s-park21/RFM95_Transparent_Serial/RFM95_Serial_Converter_PCB/Local_Library/3D_Models/Amphenol 132415.STEP

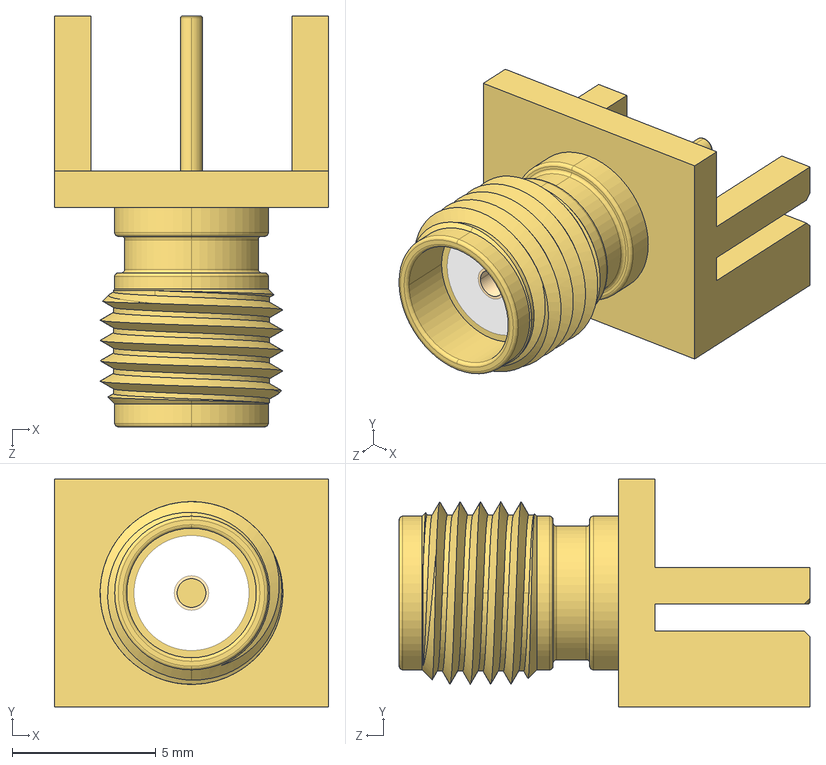
[picture p1: CAD file, 2022-06-12]
RFM95_Serial_Converter_PCB/Local_Library/3D_Models/Amphenol 132415.STEP
9.52 x 7.92 x 14.3 mm
