s-park21/RFM95_Transparent_Serial/RFM95_Serial_Converter_PCB/Local_Library/3D_Models/SM06B-GHS-TB_LF__SN_.step

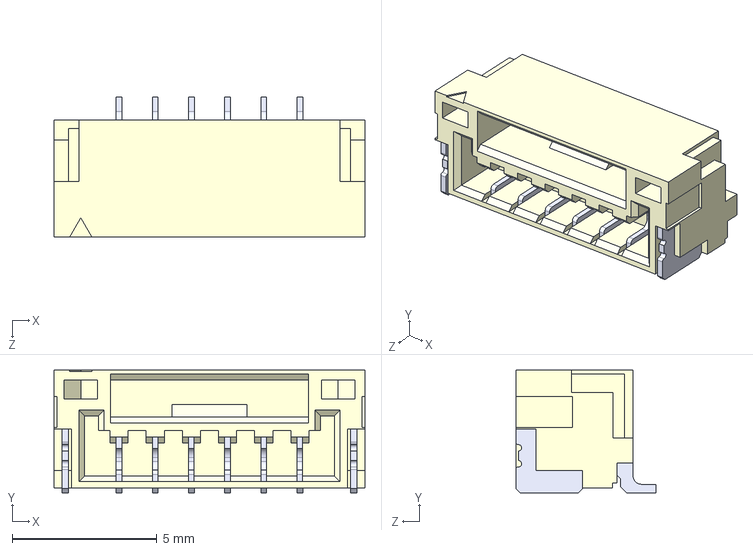
[picture p2: CAD file, 2022-06-11]
RFM95_Serial_Converter_PCB/Local_Library/3D_Models/SM06B-GHS-TB_LF__SN_.step
10.8 x 4.25 x 4.85 mm
