s-park21/RFM95_Transparent_Serial/RFM95_Serial_Converter_PCB/RFM95_Serial_Converter_PCB.kicad_pcb

## KiCad design RFM95_Serial_Converter_PCB/RFM95_Serial_Converter_PCB.kicad_pcb (2022-07-09)

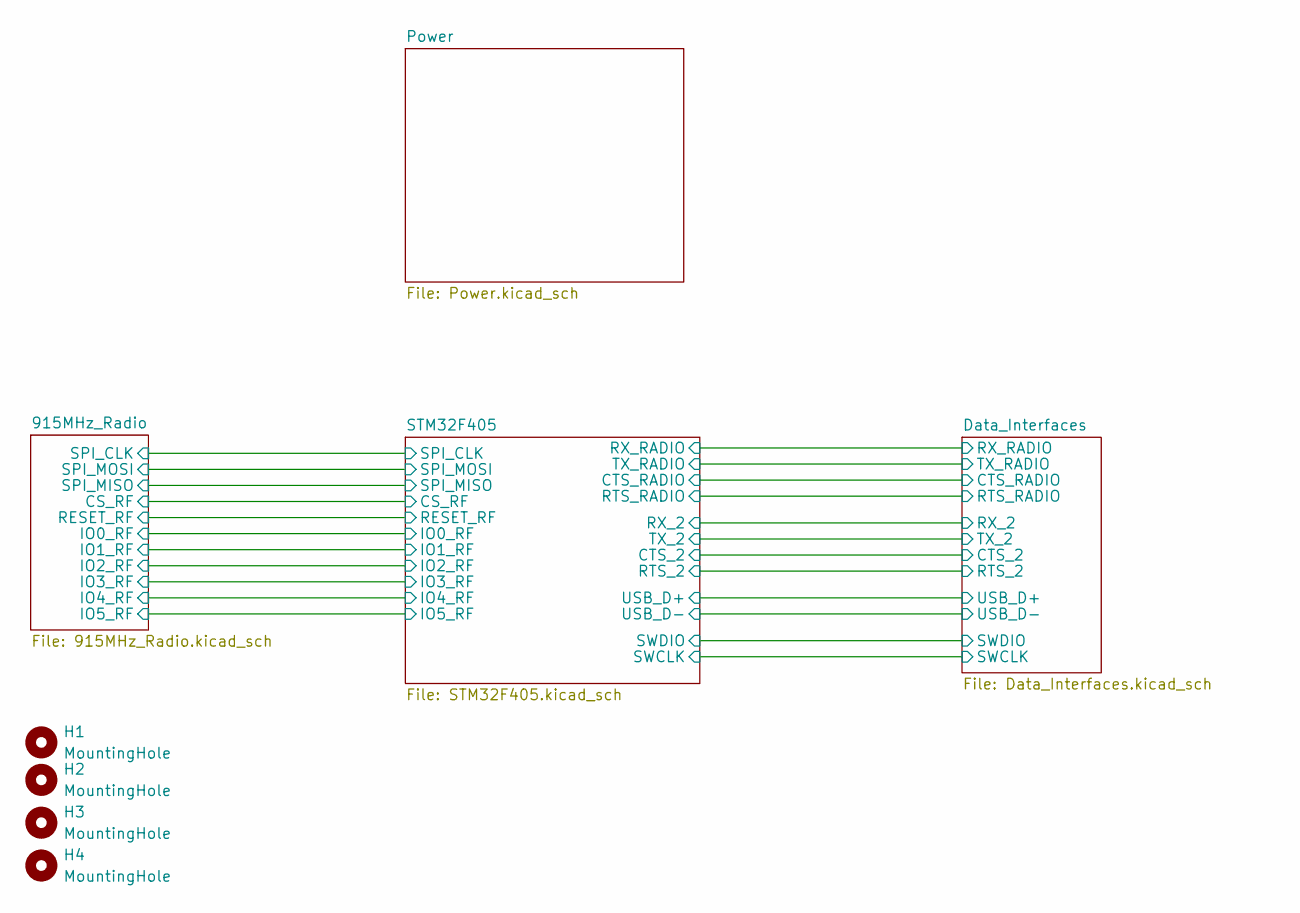
[picture p3: schematic RFM95_Serial_Converter_PCB.kicad_sch]

Parts:
H1, H2, H3, H4: MountingHole; MountingHole_2.5mm_Pad

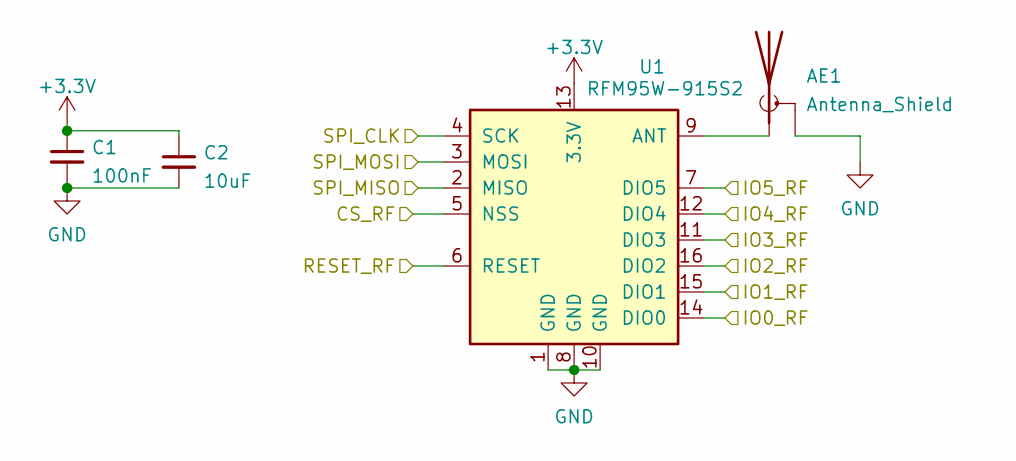
[picture p4: schematic 915MHz_Radio.kicad_sch]

Parts:
AE1: Antenna_Shield; SMA_Amphenol_132289_EdgeMount; LCSC C496550
C1: 100nF; C_0603_1608Metric_Pad1.08x0.95mm_HandSolder
C2: 10uF; C_0603_1608Metric_Pad1.08x0.95mm_HandSolder
U1: RFM95W-915S2; HOPERF_RFM9XW_SMD

Connections:
+3V3: C1.1, C2.1, U1.13 (3.3V); also elsewhere on the board
/915MHz_Radio/CS_RF: U1.5 (NSS); also elsewhere on the board
/915MHz_Radio/IO0_RF: U1.14 (DIO0); also elsewhere on the board
/915MHz_Radio/IO1_RF: U1.15 (DIO1); also elsewhere on the board
/915MHz_Radio/IO2_RF: U1.16 (DIO2); also elsewhere on the board
/915MHz_Radio/IO3_RF: U1.11 (DIO3); also elsewhere on the board
/915MHz_Radio/IO4_RF: U1.12 (DIO4); also elsewhere on the board
/915MHz_Radio/IO5_RF: U1.7 (DIO5); also elsewhere on the board
/915MHz_Radio/RESET_RF: U1.6 (RESET); also elsewhere on the board
/915MHz_Radio/SPI_CLK: U1.4 (SCK); also elsewhere on the board
/915MHz_Radio/SPI_MISO: U1.2 (MISO); also elsewhere on the board
/915MHz_Radio/SPI_MOSI: U1.3 (MOSI); also elsewhere on the board
GND: AE1.2 (Shield), C1.2, C2.2, U1.1 (GND), U1.8 (GND), U1.10 (GND); also elsewhere on the board
unnamed: AE1.1 (A), U1.9 (ANT)

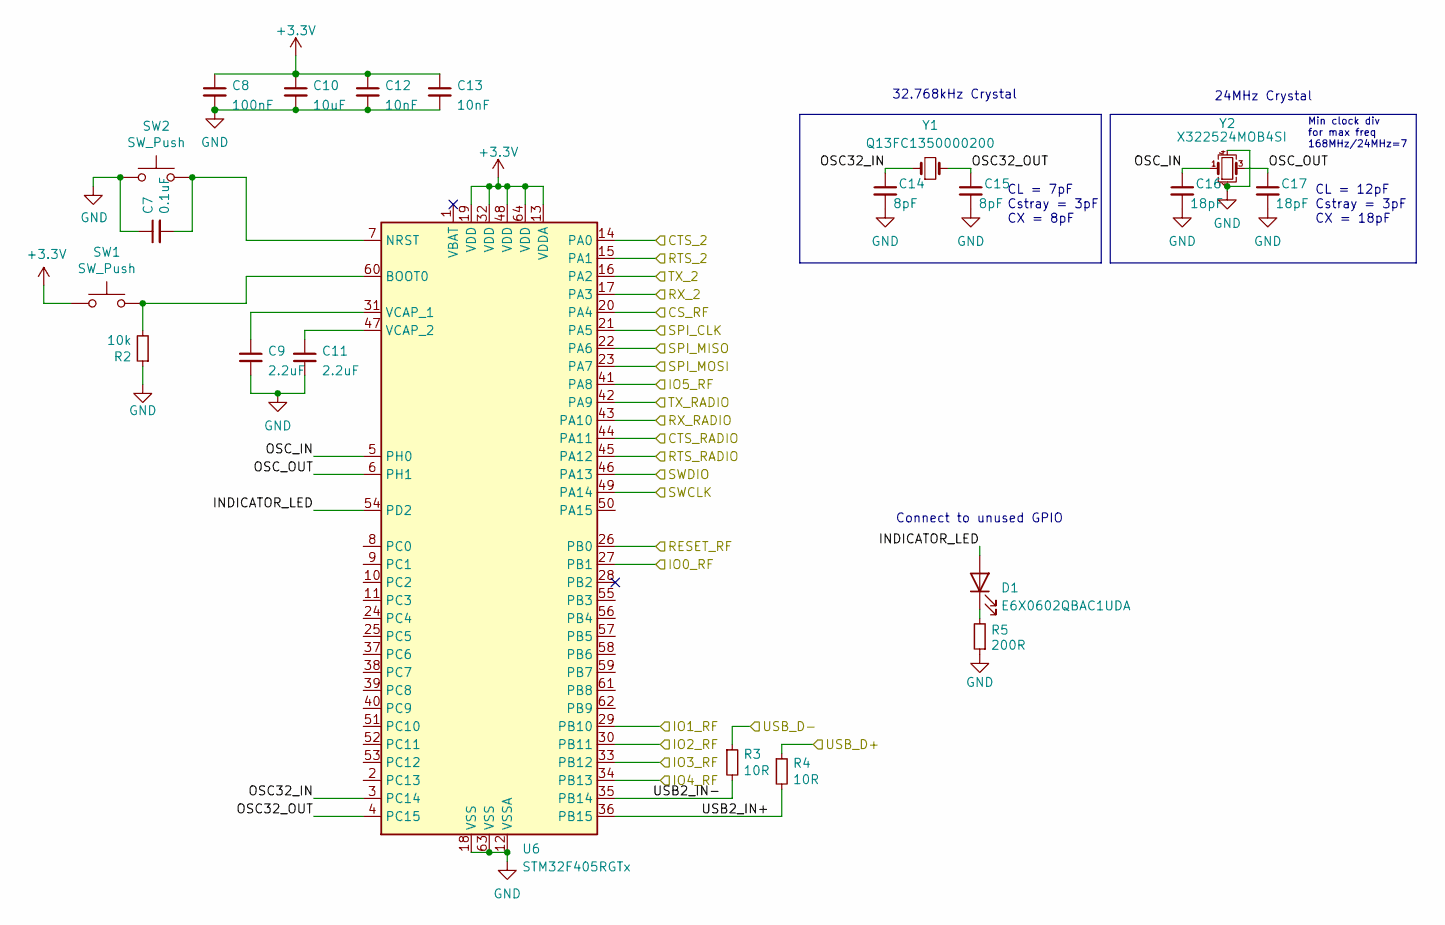
[picture p5: schematic STM32F405.kicad_sch]

Parts:
C7: 0.1uF; C_0603_1608Metric_Pad1.08x0.95mm_HandSolder
C8: 100nF; C_0603_1608Metric_Pad1.08x0.95mm_HandSolder
C9, C11: 2.2uF; C_0603_1608Metric_Pad1.08x0.95mm_HandSolder
C10: 10uF; C_0603_1608Metric_Pad1.08x0.95mm_HandSolder
C12, C13: 10nF; C_0603_1608Metric_Pad1.08x0.95mm_HandSolder
C14, C15: 8pF; C_0603_1608Metric_Pad1.08x0.95mm_HandSolder
C16, C17: 18pF; C_0603_1608Metric_Pad1.08x0.95mm_HandSolder
D1: E6X0602QBAC1UDA; LED_0603_1608Metric_Pad1.05x0.95mm_HandSolder; MFR# E6X0602QBAC1UDA; LCSC# C375467
R2: 10k; R_0603_1608Metric_Pad0.98x0.95mm_HandSolder
R3, R4: 10R; R_0603_1608Metric_Pad0.98x0.95mm_HandSolder
R5: 200R; R_0603_1608Metric_Pad0.98x0.95mm_HandSolder
SW1, SW2: SW_Push; SW_Push_1P1T_NO_CK_KSC6xxJ
U6: STM32F405RGTx; LQFP-64_10x10mm_P0.5mm
Y1: Q13FC1350000200; Crystal_SMD_3215-2Pin_3.2x1.5mm; LCSC C48615
Y2: X322524MOB4SI; Crystal_SMD_3225-4Pin_3.2x2.5mm; LCSC C70590

Connections:
+3V3: C8.1, C10.1, C12.1, C13.1, SW1.1, U6.13 (VDDA), U6.19 (VDD), U6.32 (VDD), U6.48 (VDD), U6.64 (VDD); also elsewhere on the board
/915MHz_Radio/CS_RF: U6.20 (PA4); also elsewhere on the board
/915MHz_Radio/IO0_RF: U6.27 (PB1); also elsewhere on the board
/915MHz_Radio/IO1_RF: U6.29 (PB10); also elsewhere on the board
/915MHz_Radio/IO2_RF: U6.30 (PB11); also elsewhere on the board
/915MHz_Radio/IO3_RF: U6.33 (PB12); also elsewhere on the board
/915MHz_Radio/IO4_RF: U6.34 (PB13); also elsewhere on the board
/915MHz_Radio/IO5_RF: U6.41 (PA8); also elsewhere on the board
/915MHz_Radio/RESET_RF: U6.26 (PB0); also elsewhere on the board
/915MHz_Radio/SPI_CLK: U6.21 (PA5); also elsewhere on the board
/915MHz_Radio/SPI_MISO: U6.22 (PA6); also elsewhere on the board
/915MHz_Radio/SPI_MOSI: U6.23 (PA7); also elsewhere on the board
/Data_Interfaces/CTS_2: U6.14 (PA0); also elsewhere on the board
/Data_Interfaces/CTS_RADIO: U6.44 (PA11); also elsewhere on the board
/Data_Interfaces/RTS_2: U6.15 (PA1); also elsewhere on the board
/Data_Interfaces/RTS_RADIO: U6.45 (PA12); also elsewhere on the board
/Data_Interfaces/RX_2: U6.17 (PA3); also elsewhere on the board
/Data_Interfaces/RX_RADIO: U6.43 (PA10); also elsewhere on the board
/Data_Interfaces/SWCLK: U6.49 (PA14); also elsewhere on the board
/Data_Interfaces/SWDIO: U6.46 (PA13); also elsewhere on the board
/Data_Interfaces/TX_2: U6.16 (PA2); also elsewhere on the board
/Data_Interfaces/TX_RADIO: U6.42 (PA9); also elsewhere on the board
/Data_Interfaces/USB_D+: R4.1; also elsewhere on the board
/Data_Interfaces/USB_D-: R3.1; also elsewhere on the board
/STM32F405/INDICATOR_LED: D1.2 (A), U6.54 (PD2)
/STM32F405/OSC32_IN: C14.1, U6.3 (PC14), Y1.1
/STM32F405/OSC32_OUT: C15.1, U6.4 (PC15), Y1.2
/STM32F405/OSC_IN: C16.1, U6.5 (PH0), Y2.1
/STM32F405/OSC_OUT: C17.1, U6.6 (PH1), Y2.3
/STM32F405/USB2_IN+: R4.2, U6.36 (PB15)
/STM32F405/USB2_IN-: R3.2, U6.35 (PB14)
GND: C7.1, C8.2, C9.2, C10.2, C11.2, C12.2, C13.2, C14.2, C15.2, C16.2, C17.2, R2.1, R5.1, SW2.1, U6.12 (VSSA), U6.18 (VSS), U6.63 (VSS), Y2.2, Y2.4; also elsewhere on the board
unnamed: C7.2, SW2.2, U6.7 (NRST)
unnamed: C9.1, U6.31 (VCAP_1)
unnamed: C11.1, U6.47 (VCAP_2)
unnamed: D1.1 (K), R5.2
unnamed: R2.2, SW1.2, U6.60 (BOOT0)

Notes on the sheet:
CL = 7pF Cstray = 3pF CX = 8pF
Connect to unused GPIO
24MHz Crystal
CL = 12pF Cstray = 3pF CX = 18pF
Min clock div for max freq 168MHz/24MHz=7
32.768kHz Crystal

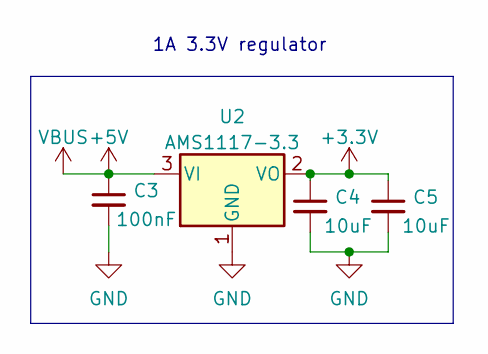
[picture p6: schematic Power.kicad_sch]

Parts:
C3: 100nF; C_0603_1608Metric_Pad1.08x0.95mm_HandSolder
C4, C5: 10uF; C_0603_1608Metric_Pad1.08x0.95mm_HandSolder
U2: AMS1117-3.3; SOT-223-3_TabPin2

Connections:
+3V3: C4.1, C5.1, U2.2 (VO); also elsewhere on the board
+5V: C3.1, U2.3 (VI); also elsewhere on the board
GND: C3.2, C4.2, C5.2, U2.1 (GND); also elsewhere on the board

Notes on the sheet:
1A 3.3V regulator

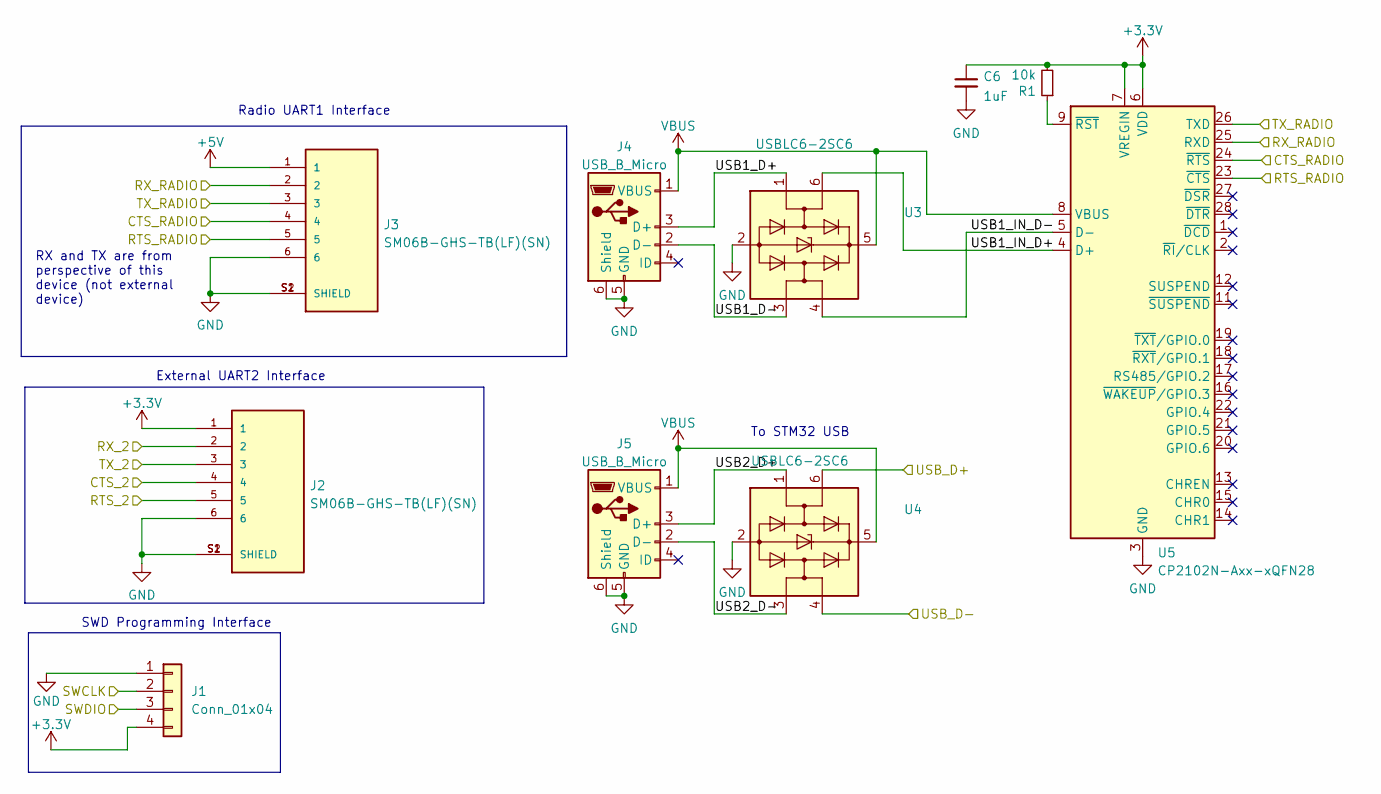
[picture p7: schematic Data_Interfaces.kicad_sch]

Parts:
C6: 1uF; C_0603_1608Metric_Pad1.08x0.95mm_HandSolder
J1: Conn_01x04; PinHeader_1x04_P2.54mm_Horizontal
J2, J3: SM06B-GHS-TB(LF)(SN); JST_SM06B-GHS-TB(LF)(SN); PARTREV N/A
J4, J5: USB_B_Micro; USB_Micro-B_Molex-105017-0001
R1: 10k; R_0603_1608Metric_Pad0.98x0.95mm_HandSolder
U3, U4: USBLC6-2SC6; SOT-23-6
U5: CP2102N-Axx-xQFN28; QFN-28-1EP_5x5mm_P0.5mm_EP3.35x3.35mm

Connections:
+3V3: C6.1, J1.4, J2.1, R1.2, U5.6 (VDD), U5.7 (VREGIN); also elsewhere on the board
+5V: J3.1, J4.1 (VBUS), J5.1 (VBUS), U3.5 (VBUS), U4.5 (VBUS), U5.8 (VBUS); also elsewhere on the board
/Data_Interfaces/CTS_2: J2.4; also elsewhere on the board
/Data_Interfaces/CTS_RADIO: J3.4, U5.24 (~RTS); also elsewhere on the board
/Data_Interfaces/RTS_2: J2.5; also elsewhere on the board
/Data_Interfaces/RTS_RADIO: J3.5, U5.23 (~CTS); also elsewhere on the board
/Data_Interfaces/RX_2: J2.2; also elsewhere on the board
/Data_Interfaces/RX_RADIO: J3.2, U5.25 (RXD); also elsewhere on the board
/Data_Interfaces/SWCLK: J1.2; also elsewhere on the board
/Data_Interfaces/SWDIO: J1.3; also elsewhere on the board
/Data_Interfaces/TX_2: J2.3; also elsewhere on the board
/Data_Interfaces/TX_RADIO: J3.3, U5.26 (TXD); also elsewhere on the board
/Data_Interfaces/USB1_D+: J4.3 (D+), U3.1 (I/O1)
/Data_Interfaces/USB1_D-: J4.2 (D-), U3.3 (I/O2)
/Data_Interfaces/USB1_IN_D+: U3.6 (I/O1), U5.4 (D+)
/Data_Interfaces/USB1_IN_D-: U3.4 (I/O2), U5.5 (D-)
/Data_Interfaces/USB2_D+: J5.3 (D+), U4.1 (I/O1)
/Data_Interfaces/USB2_D-: J5.2 (D-), U4.3 (I/O2)
/Data_Interfaces/USB_D+: U4.6 (I/O1); also elsewhere on the board
/Data_Interfaces/USB_D-: U4.4 (I/O2); also elsewhere on the board
GND: C6.2, J1.1, J2.6, J2.S1 (SHIELD), J2.S2 (SHIELD), J3.6, J3.S1 (SHIELD), J3.S2 (SHIELD), J4.5 (GND), J4.6 (Shield), J5.5 (GND), J5.6 (Shield), U3.2 (GND), U4.2 (GND), U5.3 (GND), U5.29 (GND); also elsewhere on the board
unnamed: R1.1, U5.9 (~RST)

Notes on the sheet:
External UART2 Interface
To STM32 USB
RX and TX are from perspective of this device (not external device)
SWD Programming Interface
Radio UART1 Interface

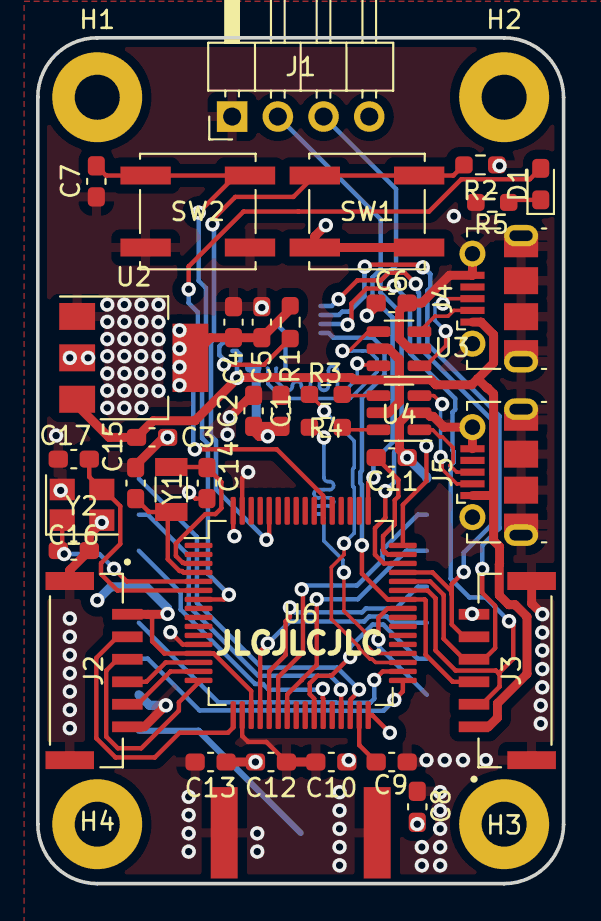
[picture p8: board RFM95_Serial_Converter_PCB.kicad_pcb from above]

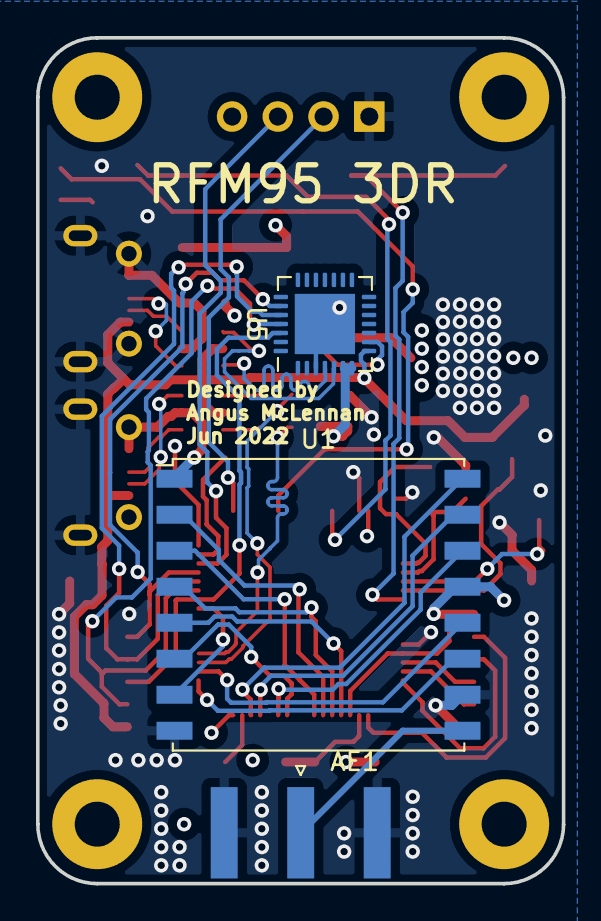
[picture p9: board RFM95_Serial_Converter_PCB.kicad_pcb from below]

Board: 4 copper layers, 29.2 x 47.0 mm, 43 parts (3 on the bottom side), 46 nets.
