s-park21/RFM95_Transparent_Serial/RFM95_Transparent_Serial/Core/Src/main.c

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
/* Includes ------------------------------------------------------------------*/
#include "main.h"
#include "usb_device.h"

/* USER CODE BEGIN Includes */
#include <stdbool.h>
#include "retarget.h"
#include "LoRa.h"
/* USER CODE END Includes */

/* USER CODE BEGIN PTD */

// ************** Below is used to define if the device is a slave or master *******************
//#define SLAVE_DEVICE
#define MASTER_DEVICE
// *********************************************************************************************

/* USER CODE END PTD */

 SPI_HandleTypeDef hspi1;

TIM_HandleTypeDef htim2;

UART_HandleTypeDef huart1;
UART_HandleTypeDef huart2;
DMA_HandleTypeDef hdma_usart1_rx;

/* USER CODE BEGIN PV */
UART_HandleTypeDef* USB_UART = &huart1;
SPI_HandleTypeDef* RF_SPI = &hspi1;
TIM_HandleTypeDef* Poll_Timer = &htim2;

#define HEADER_STRING_SIZE 4
#define MAX_RF_PACKET_SIZE 256
#define MAX_SERIAL_PACKET_SIZE(MAX_RF_PACKET_SIZE) (MAX_RF_PACKET_SIZE*2)
#define PREAMBLE_SIZE(HEADER_STRING_SIZE) (HEADER_STRING_SIZE+sizeof(uint16_t))
#define MAX_DATA_SIZE(MAX_RF_PACKET_SIZE, HEADER_STRING_SIZE) (MAX_RF_PACKET_SIZE -  PREAMBLE_SIZE(HEADER_STRING_SIZE))
#define MAX_UART_DATA_SIZE 240

// Variable to store number of available bytes to read
uint8_t RF_available_bytes = 0;
// RF RX buffer
uint8_t RF_RX_Buff[MAX_RF_PACKET_SIZE];
uint8_t RF_TX_Buff[MAX_RF_PACKET_SIZE];
//uint8_t UART_Buff[MAX_RF_PACKET_SIZE-PREAMBLE_SIZE(HEADER_STRING_SIZE)];
uint8_t UART_Buff[2*MAX_UART_DATA_SIZE];
uint8_t UART_PACKET_SIZE = sizeof(UART_Buff)/2;
uint8_t USB_Buff[MAX_RF_PACKET_SIZE-PREAMBLE_SIZE(HEADER_STRING_SIZE)];
uint8_t RF_transmit_buffer[2*MAX_RF_PACKET_SIZE];
uint16_t RF_transmit_buff_offset = 0;
bool UART_READY = false;
bool POLL_READY = false;
bool MASTER_READY = false;
uint8_t USB_rx_data_len = 0; 	// Number of bytes read by usb

// static void MX_DMA_Init(void); MUST BE INIT BEFORE static void MX_USART1_UART_Init(void);

/* USER CODE END PV */

void SystemClock_Config(void);
static void MX_GPIO_Init(void);
static void MX_DMA_Init(void);
static void MX_USART1_UART_Init(void);
static void MX_USART2_UART_Init(void);
static void MX_SPI1_Init(void);

static void MX_TIM2_Init(void);
/* USER CODE BEGIN 0 */
LoRa LoRaClass;
/* USER CODE END 0 */

/**
  * @brief  The application entry point.
  * @retval int
  */
int main(void)
{
  /* USER CODE BEGIN 1 */
  RetargetInit(USB_UART);
  /* USER CODE END 1 */

  /* MCU Configuration--------------------------------------------------------*/

  /* Reset of all peripherals, Initializes the Flash interface and the Systick. */
  HAL_Init();

  /* Configure the system clock */
  SystemClock_Config();

  /* USER CODE BEGIN SysInit */
  //***************************** DMA MUST INIT BEFORE UART ***********************
  /* USER CODE END SysInit */

  /* Initialize all configured peripherals */
  MX_GPIO_Init();
  MX_USART1_UART_Init();
  MX_USART2_UART_Init();
  MX_SPI1_Init();
  MX_DMA_Init();
  MX_TIM2_Init();
  MX_USB_DEVICE_Init();
  /* USER CODE BEGIN 2 */

  // Polling timer init
  HAL_TIM_Base_Start_IT(Poll_Timer);
  // UART interrupt init
  HAL_UART_Receive_DMA (USB_UART, UART_Buff, sizeof(UART_Buff));

  // LoRa Class definitions
  LoRaClass = newLoRa();
  LoRaClass.hSPIx                 = RF_SPI;
  LoRaClass.CS_port               = RF_SPI_NSS_GPIO_Port;
  LoRaClass.CS_pin                = RF_SPI_NSS_Pin;
  LoRaClass.reset_port            = RESET_RF_GPIO_Port;
  LoRaClass.reset_pin             = RESET_RF_Pin;
  LoRaClass.DIO0_port			  = IO0_RF_GPIO_Port;
  LoRaClass.DIO0_pin			  = IO0_RF_Pin;

  LoRaClass.frequency             = 915;
  LoRaClass.spredingFactor        = SF_7;						// default = SF_7
  LoRaClass.bandWidth			  = BW_125KHz;				  	// default = BW_125KHz
  LoRaClass.crcRate				  = CR_4_5;						// default = CR_4_5
  LoRaClass.power			      = POWER_20db;					// default = 20db
  LoRaClass.overCurrentProtection = 120; 						// default = 100 mA
  LoRaClass.preamble			  = 10;		  					// default = 8;
  LoRaClass.preamble			  = FSK_MODULATION;

  HAL_GPIO_WritePin(RF_SPI_NSS_GPIO_Port, RF_SPI_NSS_Pin, GPIO_PIN_SET);

  LoRa_setModulation(&LoRaClass, FSK_MODULATION);
  LoRa_setFSKMode(&LoRaClass, PACKET_MODE);
  LoRa_setBitrate(&LoRaClass, 300);
  LoRa_setPayloadLength(&LoRaClass, 2047);

  uint8_t read = LoRa_read(&LoRaClass, RegPacketConfig1);
  read = LoRa_read(&LoRaClass, RegPacketConfig2);
  read = LoRa_read(&LoRaClass, RegOpMode);
  read = LoRa_read(&LoRaClass, RegBitrateMsb);
  read = LoRa_read(&LoRaClass, RegBitrateLsb);
  read = LoRa_read(&LoRaClass, RegDioMapping1);
  read = LoRa_read(&LoRaClass, RegDioMapping2);

  LoRa_reset(&LoRaClass);
  uint32_t result = LoRa_init(&LoRaClass);

  if(result == LORA_NOT_FOUND) {
	  Blocking_LED_Blink(1);
  }
  else if(result == LORA_UNAVAILABLE) {
	  Blocking_LED_Blink(1);
  }

  // START CONTINUOUS RECEIVING -----------------------------------
  LoRa_startReceiving(&LoRaClass);

  /* USER CODE END 2 */

  /* Infinite loop */
  /* USER CODE BEGIN WHILE */
  while (1)
  {
    /* USER CODE END WHILE */

    /* USER CODE BEGIN 3 */
	  while(1) {
		  if(LoRa_transmit(&LoRaClass, (uint8_t*)"Testing\r\n", (uint8_t)sizeof("Testing\r\n"), 1000)) {
			  printf("Transmit failed\r\n");
		  }
		  HAL_Delay(1000);
		  if(LoRa_receive(&LoRaClass, RF_RX_Buff, sizeof("Testing\r\n"))) {
			  printf("Nothing received\r\n");
		  }
	  }

	  if(RF_available_bytes) {
		  // Bytes in RF RX buffer to read
		  // Read bytes into buffer
		  LoRa_receive(&LoRaClass, RF_RX_Buff, RF_available_bytes);
		  // Buffer to contain data to be transmitted over UART and USB
		  uint8_t serialBuff[MAX_SERIAL_PACKET_SIZE(MAX_RF_PACKET_SIZE)];

		  // Check packet identifier
#ifdef MASTER_DEVICE
		  if(!memcmp(RF_RX_Buff, (uint8_t*)"SRSP", HEADER_STRING_SIZE)) {
			  HAL_GPIO_WritePin(INDICATOR_LED_GPIO_Port, INDICATOR_LED_Pin, GPIO_PIN_SET);
			  // Header byte is packet type 2 (Slave response)
			  uint16_t data_len = (uint16_t)(RF_RX_Buff[HEADER_STRING_SIZE]<<8 | RF_RX_Buff[HEADER_STRING_SIZE+1]);

			  if(data_len > MAX_DATA_SIZE(MAX_RF_PACKET_SIZE, HEADER_STRING_SIZE)) {
				  RF_available_bytes = 0;
				  // Data spans over two packets
				  // Put all available bytes into serialBuff
				  memcpy(serialBuff,  &RF_RX_Buff[PREAMBLE_SIZE(HEADER_STRING_SIZE)], MAX_DATA_SIZE(MAX_RF_PACKET_SIZE, HEADER_STRING_SIZE));
				  memset(RF_RX_Buff, '\0', sizeof(RF_RX_Buff));
				  // Wait for next packet
				  while(memcmp(RF_RX_Buff, (uint8_t*)"SRSP", HEADER_STRING_SIZE) != 0) {
					  LoRa_receive(&LoRaClass, RF_RX_Buff, data_len - MAX_RF_PACKET_SIZE);
				  }
				  data_len = (uint16_t)(RF_RX_Buff[HEADER_STRING_SIZE]<<8 | RF_RX_Buff[HEADER_STRING_SIZE+1]);
				  // Add new data to end of previous packet
				  memcpy(&serialBuff[MAX_DATA_SIZE(MAX_RF_PACKET_SIZE, HEADER_STRING_SIZE)], &RF_RX_Buff[PREAMBLE_SIZE(HEADER_STRING_SIZE)], data_len);
				  // Transmit concatenated buffer over USB and UART
				  CDC_Transmit_HS(serialBuff, MAX_DATA_SIZE(MAX_RF_PACKET_SIZE, HEADER_STRING_SIZE) + data_len);
				  HAL_UART_Transmit(USB_UART, serialBuff, MAX_DATA_SIZE(MAX_RF_PACKET_SIZE, HEADER_STRING_SIZE) + data_len, 1000);
				  RF_available_bytes = 0;
			  }
			  else {
				  // Data is all contained within one packet
				  // Transmit bytes from RF_RX_Buff over UART not including packet identifier or data length field
				  HAL_UART_Transmit(USB_UART, &RF_RX_Buff[PREAMBLE_SIZE(HEADER_STRING_SIZE)], RF_available_bytes-PREAMBLE_SIZE(HEADER_STRING_SIZE), 1000);
				  // Transmit bytes from RF_RX Buff over USB not including packet identifier
				  CDC_Transmit_HS(&RF_RX_Buff[PREAMBLE_SIZE(HEADER_STRING_SIZE)], RF_available_bytes-PREAMBLE_SIZE(HEADER_STRING_SIZE));
				  RF_available_bytes = 0;
			  }
			  HAL_GPIO_WritePin(INDICATOR_LED_GPIO_Port, INDICATOR_LED_Pin, GPIO_PIN_RESET);
		  }

#elif defined SLAVE_DEVICE
		  if(!memcmp(RF_RX_Buff, (uint8_t*)"MREQ", HEADER_STRING_SIZE)) {
			  HAL_GPIO_WritePin(INDICATOR_LED_GPIO_Port, INDICATOR_LED_Pin, GPIO_PIN_SET);
			  MASTER_READY = true;
			  // Header byte is packet type 1 (Master request)
			  uint16_t data_len = (uint16_t)(RF_RX_Buff[HEADER_STRING_SIZE]<<8 | RF_RX_Buff[HEADER_STRING_SIZE+1]);
			  if(data_len > MAX_DATA_SIZE(MAX_RF_PACKET_SIZE, HEADER_STRING_SIZE)) {
				  RF_available_bytes = 0;
				  // Data spans over two packets
				  // Put all available bytes into serialBuff
				  memcpy(serialBuff,  &RF_RX_Buff[PREAMBLE_SIZE(HEADER_STRING_SIZE)], MAX_DATA_SIZE(MAX_RF_PACKET_SIZE, HEADER_STRING_SIZE));
				  memset(RF_RX_Buff, '\0', sizeof(RF_RX_Buff));
				  // Wait for next packet
				  while(memcmp(RF_RX_Buff, (uint8_t*)"SRSP", HEADER_STRING_SIZE) != 0) {
					  LoRa_receive(&LoRaClass, RF_RX_Buff, data_len - MAX_RF_PACKET_SIZE);
				  }
				  data_len = (uint16_t)(RF_RX_Buff[HEADER_STRING_SIZE]<<8 | RF_RX_Buff[HEADER_STRING_SIZE+1]);
				  // Add new data to end of previous packet
				  memcpy(&serialBuff[MAX_DATA_SIZE(MAX_RF_PACKET_SIZE, HEADER_STRING_SIZE)], &RF_RX_Buff[PREAMBLE_SIZE(HEADER_STRING_SIZE)], data_len);
				  // Transmit concatenated buffer over USB and UART
				  CDC_Transmit_HS(serialBuff, MAX_DATA_SIZE(MAX_RF_PACKET_SIZE, HEADER_STRING_SIZE) + data_len);
				  HAL_UART_Transmit(USB_UART, serialBuff, MAX_DATA_SIZE(MAX_RF_PACKET_SIZE, HEADER_STRING_SIZE) + data_len, 1000);
				  RF_available_bytes = 0;
			  }
			  else if (data_len > 0) {
				  // Data is all contained within one packet
				  // Transmit bytes from RF_RX_Buff over UART not including packet identifier or data length field
				  HAL_UART_Transmit(USB_UART, &RF_RX_Buff[PREAMBLE_SIZE(HEADER_STRING_SIZE)], RF_available_bytes-PREAMBLE_SIZE(HEADER_STRING_SIZE), 1000);
				  // Transmit bytes from RF_RX Buff over USB not including packet identifier
				  CDC_Transmit_HS(&RF_RX_Buff[PREAMBLE_SIZE(HEADER_STRING_SIZE)], RF_available_bytes-PREAMBLE_SIZE(HEADER_STRING_SIZE));
				  RF_available_bytes = 0;
			  }
			  HAL_GPIO_WritePin(INDICATOR_LED_GPIO_Port, INDICATOR_LED_Pin, GPIO_PIN_RESET);
		  }
		  else RF_available_bytes = 0;
#endif
	  }

#ifdef MASTER_DEVICE
	  if (POLL_READY) {
		  if(UART_READY) {
			  UART_READY = false;
			  uint8_t sendBuff[MAX_RF_PACKET_SIZE];
			  // Add packet identifier
			  memcpy(&sendBuff, (uint8_t*)"MREQ", sizeof("MREQ"));
			  // Add data length field
			  memcpy(&sendBuff[sizeof("MREQ")], &UART_PACKET_SIZE, sizeof(uint16_t));
			  // Add data to sendBuff
			  memcpy(&sendBuff[PREAMBLE_SIZE(HEADER_STRING_SIZE)], &RF_transmit_buffer, UART_PACKET_SIZE);
			  // Transmit USB buffer over RF
			  if (!LoRa_transmit(&LoRaClass, sendBuff, RF_transmit_buff_offset+PREAMBLE_SIZE(HEADER_STRING_SIZE), 1000)) {
						  // Print error msg
			  }
			  RF_transmit_buff_offset = 0;
			  LoRa_startReceiving(&LoRaClass);
		  }
		  if(!UART_READY && !USB_rx_data_len) {
			  uint8_t sendBuff[MAX_RF_PACKET_SIZE];
			  // Send empty data packet
			  // Add packet identifier
			  memcpy(&sendBuff, (uint8_t*)"MREQ\0\0", sizeof("MREQ\0\0"));
			  if (!LoRa_transmit(&LoRaClass, sendBuff, PREAMBLE_SIZE(HEADER_STRING_SIZE), 1000)) {
				  // Print error msg
			  }
		  }
	  }
	  POLL_READY = false;

#elif defined SLAVE_DEVICE
	  if(MASTER_READY) {
		  MASTER_READY = false;
		  if(UART_READY) {
			  UART_READY = false;
			  HAL_GPIO_WritePin(INDICATOR_LED_GPIO_Port, INDICATOR_LED_Pin, GPIO_PIN_SET);
			  uint8_t sendBuff[MAX_RF_PACKET_SIZE];
			  // Add packet identifier
			  memcpy(&sendBuff, (uint8_t*)"SRSP", sizeof("SRSP"));
			  // Add data length field
			  memcpy(&sendBuff[sizeof("SRSP")], &UART_PACKET_SIZE, sizeof(uint16_t));
			  // Add data to sendBuff
			  memcpy(&sendBuff[PREAMBLE_SIZE(HEADER_STRING_SIZE)], &RF_transmit_buffer, UART_PACKET_SIZE);
			  // Transmit USB buffer over RF
			  if (!LoRa_transmit(&LoRaClass, sendBuff, UART_PACKET_SIZE+PREAMBLE_SIZE(HEADER_STRING_SIZE), 1000)) {
						  // Print error msg
			  }
			  RF_transmit_buff_offset = 0;
			  LoRa_startReceiving(&LoRaClass);
			  HAL_GPIO_WritePin(INDICATOR_LED_GPIO_Port, INDICATOR_LED_Pin, GPIO_PIN_RESET);
		  }
	  }
#endif
  }
  /* USER CODE END 3 */
}

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
/* USER CODE BEGIN 4 */
void HAL_GPIO_EXTI_Callback(uint16_t GPIO_Pin){
	if(GPIO_Pin == LoRaClass.DIO0_pin){
		RF_available_bytes = LoRa_received_bytes(&LoRaClass);
	}
}

void HAL_UART_RxCpltCallback(UART_HandleTypeDef *huart)
{
	HAL_UART_Receive_DMA (USB_UART, UART_Buff, sizeof(UART_Buff));
	UART_READY = true;
	// Add second half of data to sendBuff
	memcpy(RF_transmit_buffer, &UART_Buff[UART_PACKET_SIZE], UART_PACKET_SIZE);
}

void HAL_UART_RxHalfCpltCallback(UART_HandleTypeDef *huart) {
	UART_READY = true;
	// Add first half of data to sendBuff
	memcpy(RF_transmit_buffer, &UART_Buff, UART_PACKET_SIZE);
}


#ifdef MASTER_DEVICE
void HAL_TIM_PeriodElapsedCallback(TIM_HandleTypeDef* htim)
{
    if(htim == Poll_Timer) {
    	// Poll slave device
    	POLL_READY = true;
    }
}
#endif

void Blocking_LED_Blink(uint8_t freq) {
	while(1) {
		HAL_GPIO_WritePin(INDICATOR_LED_GPIO_Port, INDICATOR_LED_Pin, GPIO_PIN_SET);
		HAL_Delay(1000/freq);
		HAL_GPIO_WritePin(INDICATOR_LED_GPIO_Port, INDICATOR_LED_Pin, GPIO_PIN_RESET);
		HAL_Delay(1000/freq);
	}
}

/* USER CODE END 4 */
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
