s-park21/RFM95_Transparent_Serial/Data_Rate_Test/RFM95_Transparent_Serial.ioc

Mcu.UserName=STM32F405RGTx
PA0-WKUP.Signal=USART2_CTS
PA1.Signal=USART2_RTS
PA10.Signal=USART1_RX
PA11.Signal=USART1_CTS
PA12.Signal=USART1_RTS
PA13.Signal=SYS_JTMS-SWDIO
PA14.Signal=SYS_JTCK-SWCLK
PA2.Signal=USART2_TX
PA3.Signal=USART2_RX
PA4.GPIO_Label=RF_SPI_NSS
PA4.Signal=GPIO_Output
PA5.Signal=SPI1_SCK
PA6.Signal=SPI1_MISO
PA7.Signal=SPI1_MOSI
PA8.GPIO_Label=IO5_RF
PA8.Signal=GPXTI8
PA9.Signal=USART1_TX
PB0.GPIO_Label=RESET_RF
PB0.Signal=GPIO_Output
PB1.GPIO_Label=IO0_RF
PB1.Signal=GPXTI1
PB10.GPIO_Label=IO1_RF
PB10.Signal=GPXTI10
PB11.GPIO_Label=IO2_RF
PB11.Signal=GPXTI11
PB12.GPIO_Label=IO3_RF
PB12.Signal=GPXTI12
PB13.GPIO_Label=IO4_RF
PB13.Signal=GPXTI13
PB14.Signal=USB_OTG_HS_DM
PB15.Signal=USB_OTG_HS_DP
PC14-OSC32_IN.Signal=RCC_OSC32_IN
PC15-OSC32_OUT.Signal=RCC_OSC32_OUT
PD2.GPIO_Label=INDICATOR_LED
PD2.Signal=GPIO_Output
PH0-OSC_IN.Signal=RCC_OSC_IN
PH1-OSC_OUT.Signal=RCC_OSC_OUT
