s-park21/RFM95_Transparent_Serial/(commit log)

2022-06-11 Inital setup
    [RFM95_Serial_Converter_PCB.kicad_pcb, RFM95_Serial_Converter_PCB.kicad_sch]
2022-06-11 Swapped to stm32F405
    [RFM95_Serial_Converter_PCB.kicad_sch, SM06B-GHS-TB_LF__SN_.step]
2022-06-11 Schematic almost finished
    [RFM95_Serial_Converter_PCB.kicad_sch]
2022-06-12 Started component placement
    [915MHz_Radio.kicad_sch, Data_Interfaces.kicad_sch, Power.kicad_sch, RFM95_Serial_Converter_PCB.kicad_pcb, RFM95_Serial_Converter_PCB.kicad_sch, STM32F405.kicad_sch]
2022-06-12 Finalised component placement and board edge
    [915MHz_Radio.kicad_sch, Amphenol 132415.STEP, RFM95_Serial_Converter_PCB.kicad_pcb, RFM95_Serial_Converter_PCB.kicad_sch, STM32F405.kicad_sch]
2022-06-15 Routed and ready to order
    [Data_Interfaces.kicad_sch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]
2022-06-15 Repositioned indicator led and exported step
    [RFM95_Serial_Converter_PCB.csv, RFM95_Serial_Converter_PCB.kicad_pcb, RFM95_Serial_Converter_PCB.kicad_sch, STM32F405.kicad_sch]
2022-06-26 Started STM32 cube mx files
2022-07-09 Working verison of code
    [RFM95_Serial_Converter_PCB-B_Cu.gbr, RFM95_Serial_Converter_PCB-B_Mask.gbr, RFM95_Serial_Converter_PCB-B_Paste.gbr, RFM95_Serial_Converter_PCB-B_Silkscreen.gbr, RFM95_Serial_Converter_PCB-Edge_Cuts.gbr, RFM95_Serial_Converter_PCB-F_Cu.gbr, RFM95_Serial_Converter_PCB-F_Mask.gbr, RFM95_Serial_Converter_PCB-F_Paste.gbr]
2022-07-11 Working code and PCBs
    [Data_Interfaces.kicad_sch]
2022-08-02 Working DMA
