s-park21/RFM95_Transparent_Serial/(notices)

Notices in the files:
RFM95_Transparent_Serial/Core/Src/main.c:
Copyright (c) 2022 STMicroelectronics.
All rights reserved.
This software is licensed under terms that can be found in the LICENSE file
